weygoldt/TeeGrid/examples/R4-logger/README.md

# R4.x logger

Logger for 2 to 16 channels based on

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

Software based on the [TeeRec](https://github.com/janscience/TeeRec) library.

Designed by Jan Benda in September 2023.

## Installation

See the [installation instructions](../../doc/install.md) for the
TeeGrid library.

## Software setup

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

*WARNING* the settings of the config file overwrite the settings made
 in the sketch!

For editing the sketch, open the
[`R4-logger.ino`](R4-logger.ino) sketch in the Arduino
IDE (`File` - `Open`, `Ctrl-O`, or `File` - `Examples` - `TeeGrid` -
`R4-senosrs-logger`) and edit it appropriately.  In the top section
marked as `Default settings` you may adapt some settings according to
your needs as described in the next sections.

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

### Data acquisition

The first section is about the data acquisition:

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

### File naming and size

The second section is about the files that store the data on the SD
card.

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

#### Special strings for the file name

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

### LED pin

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

## Configuration file

Most of the settings described above can be configured via a
configuration file. Simply place a configuration file named
[`logger.cfg`](logger.cfg) into the root folder of the SD card. If
present, this file is read once on startup. The configuration file
will overwrite the settings made in the
[`R4-logger.ino`](R4-logger.ino) sketch.

The content of the configuration file should look like this:

```txt
Settings:
  Path:            recordings
  FileName:        logger1-SDATETIME.wav
  FileTime:        5min
  InitialDelay:    10s
ADC:
  SamplingRate: 48.0kHz
  NChannels:    16
  Gain:         20.0dB
``` 

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

## Real-time clock

For proper naming of files, the real-time clock needs to be set to the
right time. The easiest way to achieve this, is to compile and upload
the [`R4-logger.ino`](R4-logger.ino) sketch from the
Arduino IDE. The upload also sets the on-bard real-time clock to the
time of the computer. Use the serial monitor to check the output of
the sketch. At the beginning it reports the time. Disconnect the
Teensy from the USB and simply reconnect it. If it then reports on the
serial monitor the right time, the real time clock is properly set and
is properly powered by the coin battery.

Alternatively, you may copy a file named `settime.cfg` into the root
folder of the SD card. This file contains a single line with a date
and a time in the following format:
``` txt
YYYY-MM-DDTHH:MM:SS
```

In a shell you might generate this file via
```sh
date +%FT%T > settime.cfg
```
and then edit this file to some time in the near future.

Insert the SD card into the Teensy. Start the Teensy exactly at the
time that is written into the `settime.cfg` file by connecting it to
power. On start up the
[`R4-logger.ino`](R4-logger.ino) sketch reads in the
`settime.cfg` file, sets the real-time clock to this time, and then
deletes the file from the SD card to avoid resetting the time at the
next start up.

## Check logger function

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

```txt
=======================================================================

RTC (on-board) current time: 2024-07-23T10:24:08      # this should be the current time and not 2019-01-01T00:00:02

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

Settings:                                             # check whether these configuration settings are right
  Path:         recordings
  FileName:     logger1-SDATETIME.wav
  FileTime:     20s
  PulseFreq:    0Hz
  InitialDelay: 10s
ADC:
  SamplingRate: 48.0kHz
  NChannels:    16
  Gain:         0.0dB
Setup PCM186x 0 on TDM 0: configured for 4 channels  # make sure all 4 chips are detected and configured for 4 channels
Setup PCM186x 1 on TDM 0: configured for 4 channels
Setup PCM186x 2 on TDM 1: configured for 4 channels
Setup PCM186x 3 on TDM 1: configured for 4 channels

TDM settings:                                        # check the sampling rate
  rate:       48.0kHz
  resolution: 32bits
  channels:   16
  swap l/r:   1
  buffer:     2.73s (2097152 samples)
  DMA time:   1.3ms

Save recorded data in folder "recordings".

logger1-2024-07-23T10:24:21.wav                     # this is the first file for storing recorded data
```

## Logging

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

### Formatting the SD card

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

Formatting from a computer also helps, but this omits the erasing
part.

### LED

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

## Files

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
