weygoldt/TeeGrid/examples/SdFormatter/README.md

# SdFormatter

... formats SD cards **immediately**. To use, connect a teensy with SD-card running the script to power. The formatter will run once and print a short summary to the serial monitor, if connected. If the built-in LED turns on, the formatting process is finished. To format a new SD-card, remove the teensy from power, swap the card and repeat the process.
