weygoldt/TeeGrid/examples/R41-CAN-grid-controller/README.md

# R4.1 CAN grid controller

Control and synchronize logger units via CAN FD bus of the [Teensy_Amp R4.1](https://github.com/janscience/Teensy_Amp/tree/main/R4.1). Each [Teensy_Amp R4.1](https://github.com/janscience/Teensy_Amp/tree/main/R4.1) logger needs
to run the [R41-CAN-recorder](../R41-CAN-recorder) software.

Designed by Jan Benda in September 2023.
