weygoldt/TeeGrid/doc/pvc-tube-housing/README.md

# PVC tube housing

housing
