weygoldt/TeeGrid/examples/8channel-logger/images/bottom-1amp.jpg

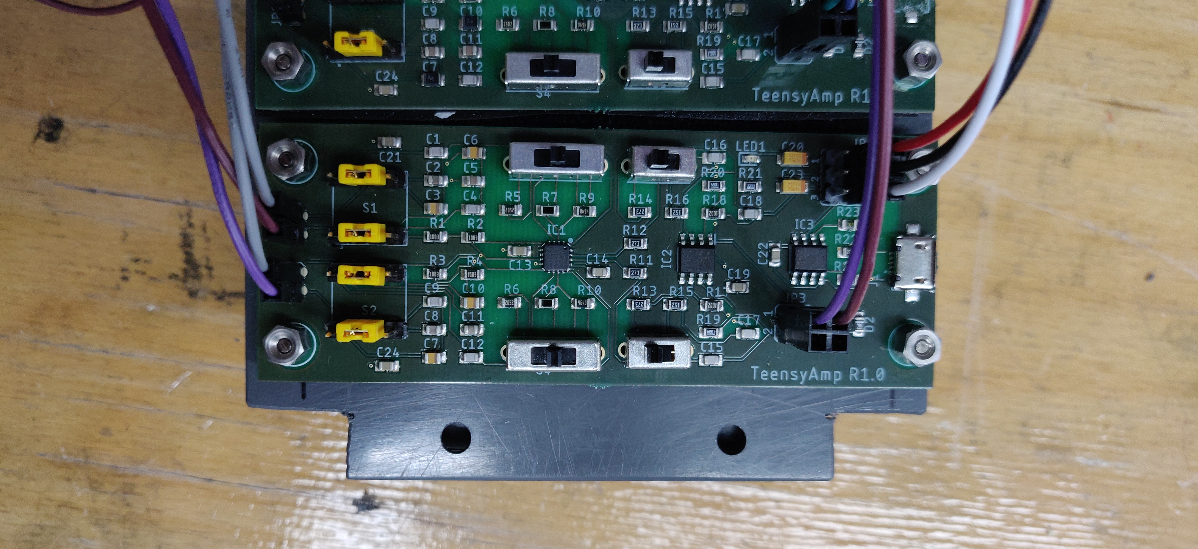
examples/8channel-logger/images/bottom-1amp.jpg
