weygoldt/TeeGrid/examples/8channel-logger/images/bottom-4amps.jpg

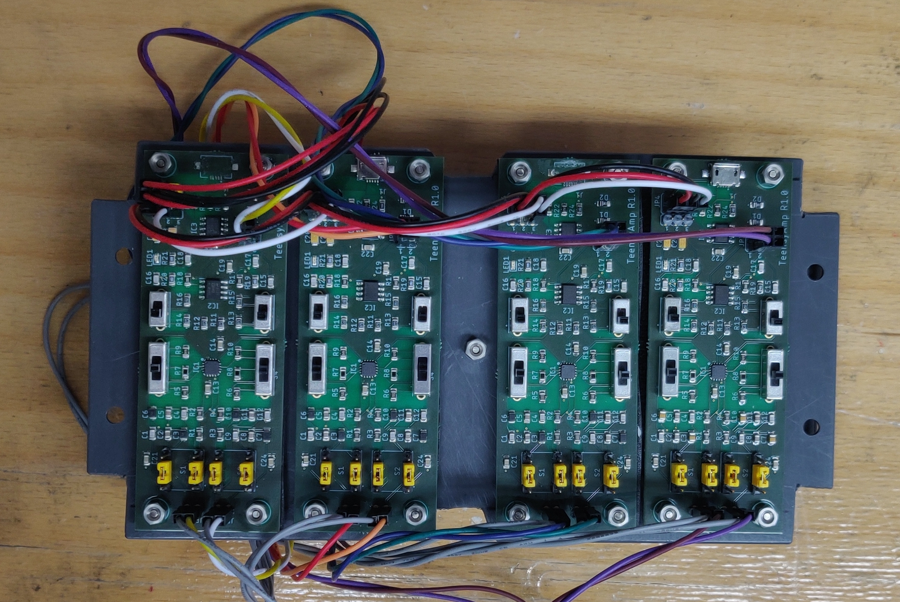
examples/8channel-logger/images/bottom-4amps.jpg
