weygoldt/TeeGrid/examples/8channel-logger/images/box-top-annotated.jpg

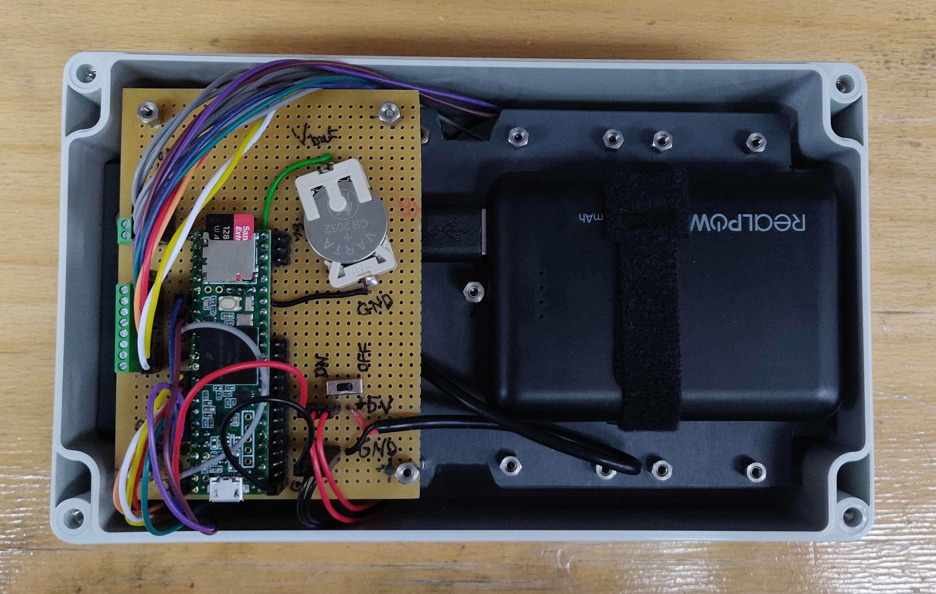
examples/8channel-logger/images/box-top-annotated.jpg
