weygoldt/TeeGrid/examples/8channel-logger/images/box.jpg

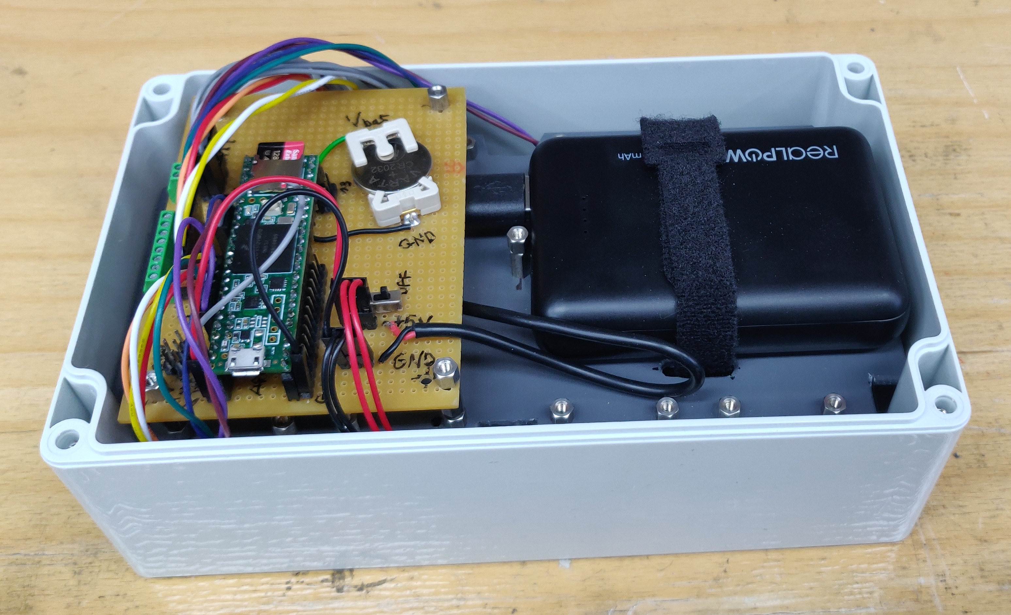
examples/8channel-logger/images/box.jpg
