weygoldt/TeeGrid/examples/8channel-logger/images/connectors.jpg

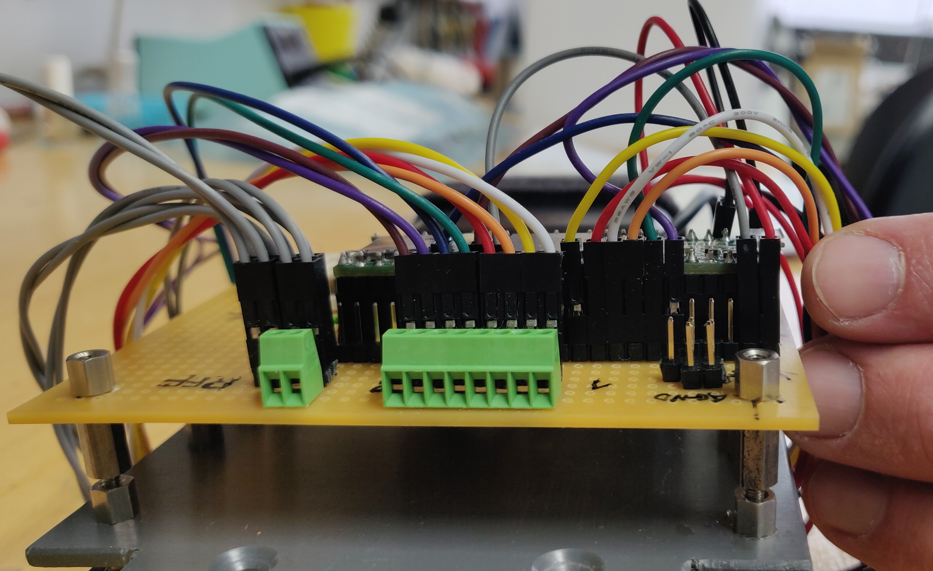
examples/8channel-logger/images/connectors.jpg
