weygoldt/TeeGrid/examples/8channel-logger/images/filter-p2-gain30-23mV-traces.png

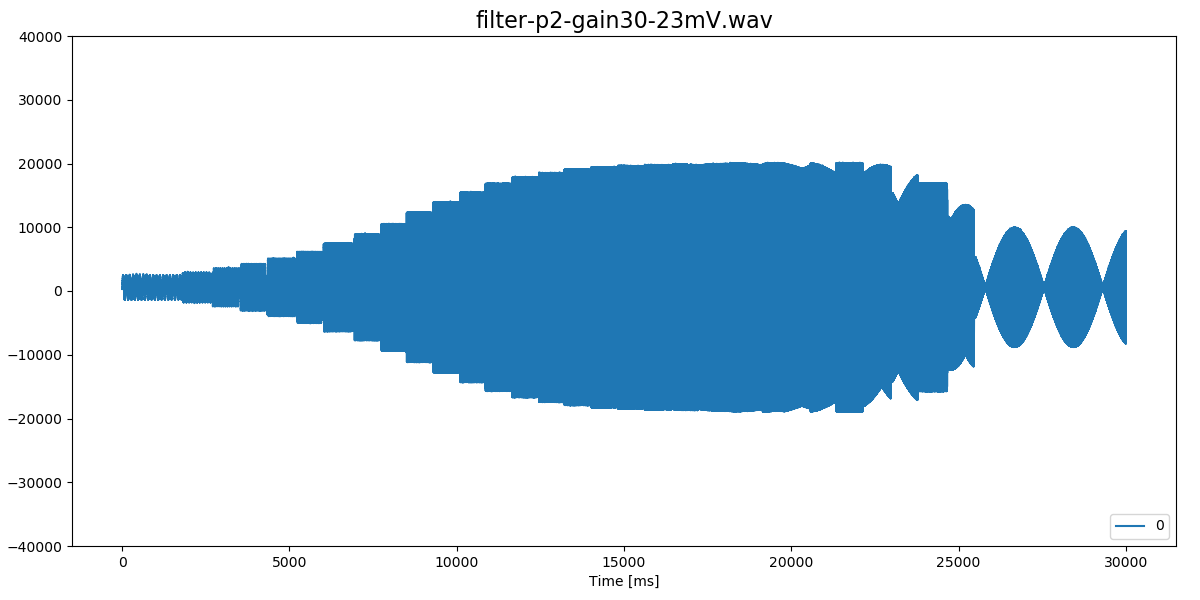
examples/8channel-logger/images/filter-p2-gain30-23mV-traces.png
