weygoldt/TeeGrid/examples/8channel-logger/images/filter-p3-gain30-23mV-traces.png

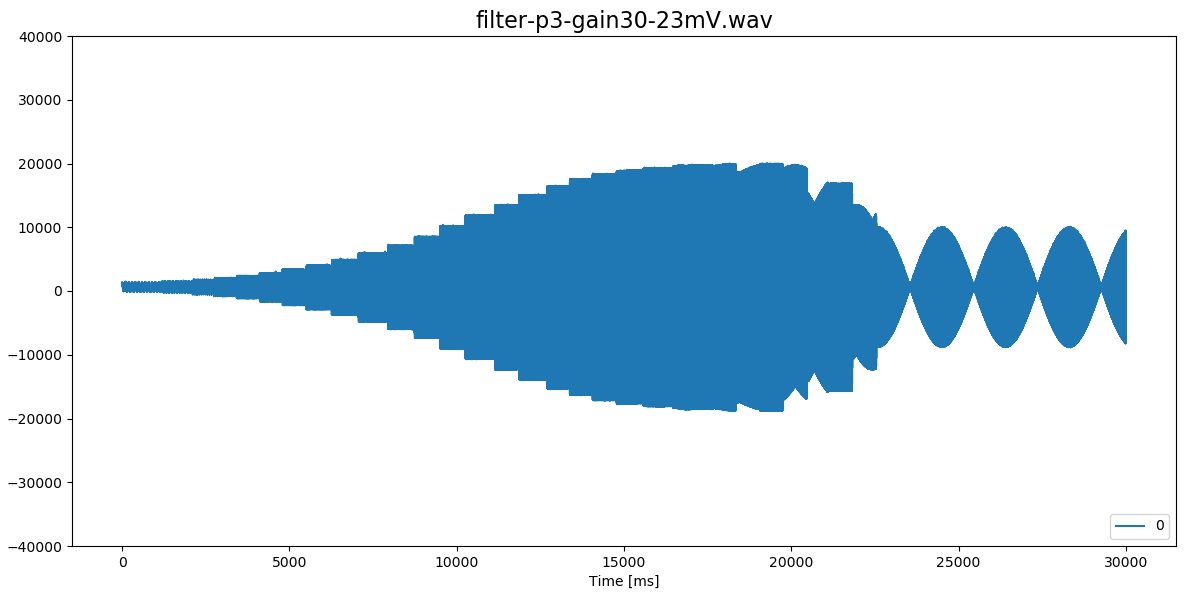
examples/8channel-logger/images/filter-p3-gain30-23mV-traces.png
