weygoldt/TeeGrid/examples/8channel-logger/images/top.jpg

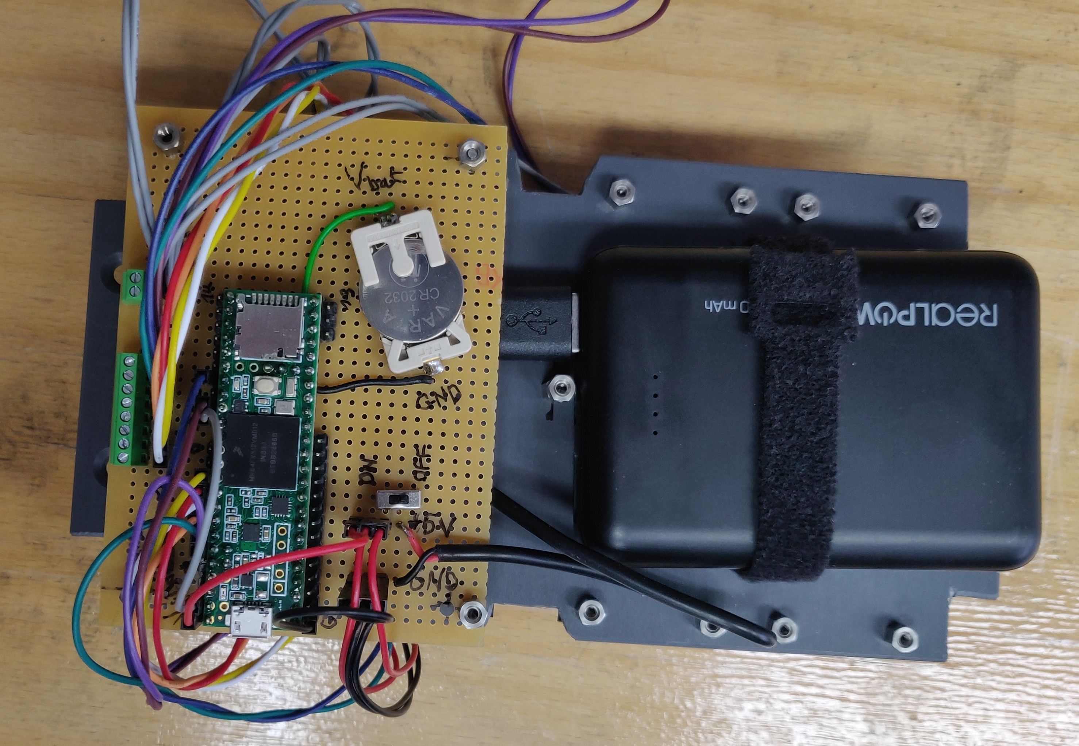
examples/8channel-logger/images/top.jpg
