weygoldt/TeeGrid/examples/R4-sensors-logger/logger-periphery-connections.jpg

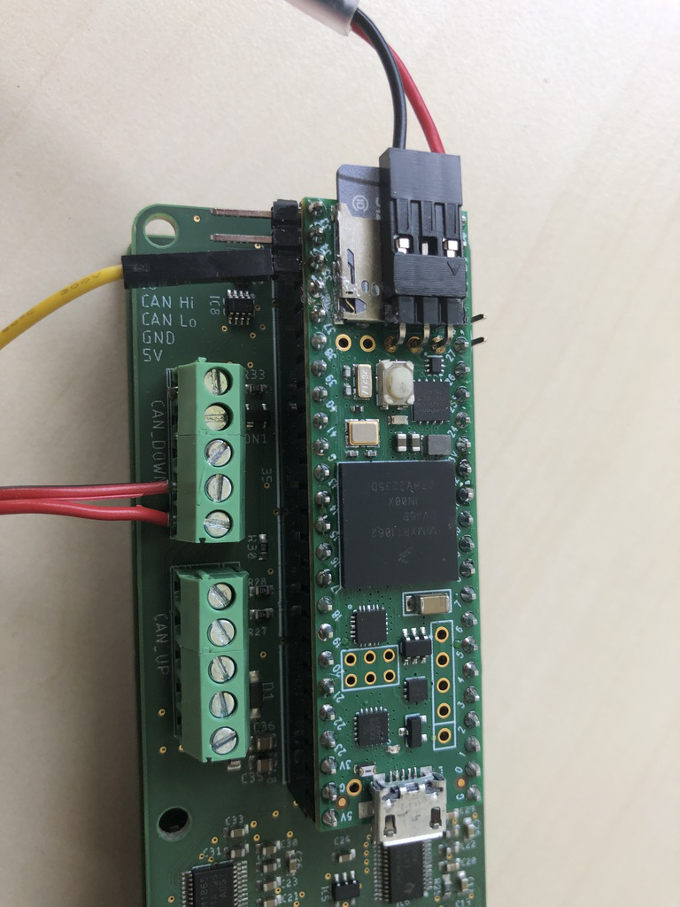
examples/R4-sensors-logger/logger-periphery-connections.jpg
