weygoldt/TeeGrid/examples/8channel-logger/images/clipping-gain5-100mV-step10mV-traces.png

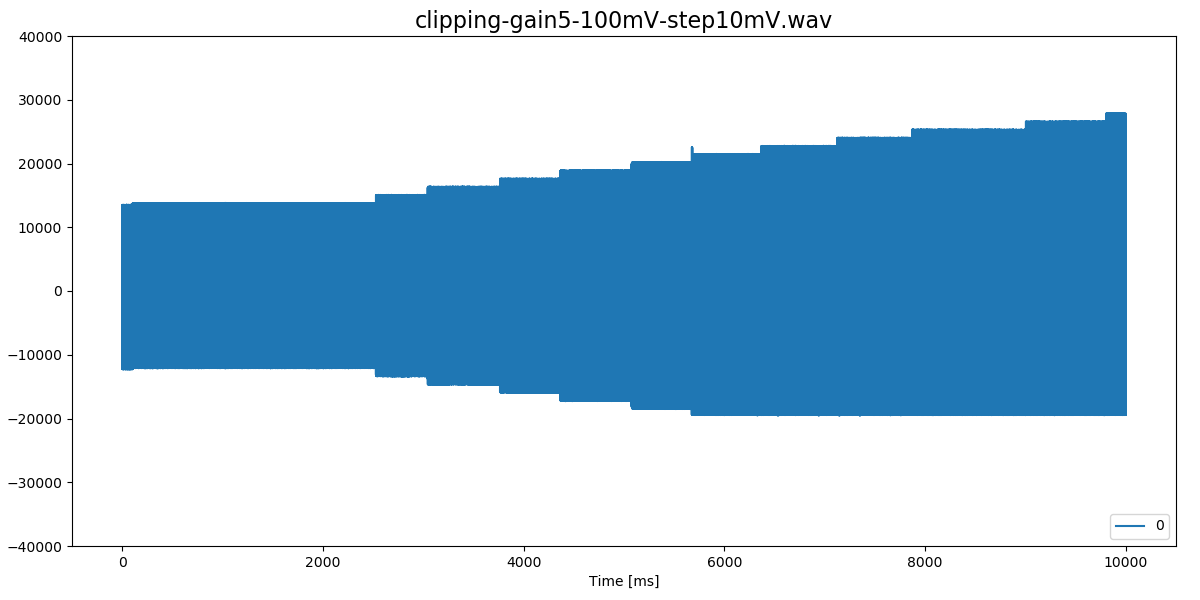
examples/8channel-logger/images/clipping-gain5-100mV-step10mV-traces.png
