weygoldt/TeeGrid/src/SetupPCM.cpp

#include <SetupPCM.h>


bool R40SetupPCM(InputTDM &tdm, ControlPCM186x &cpcm, bool offs,
		 float pregain, const InputTDMSettings &aisettings,
		 ControlPCM186x **pcm) {
  cpcm.begin();
  bool r = cpcm.setMicBias(false, true);
  if (!r) {
    Serial.println("not available");
    return false;
  }
  cpcm.setRate(tdm, aisettings.rate());
  if (tdm.nchannels() < aisettings.nchannels()) {
    if (aisettings.nchannels() - tdm.nchannels() == 2) {
      if (pregain == 1.0) {
        cpcm.setupTDM(tdm, ControlPCM186x::CH3L, ControlPCM186x::CH3R,
	              offs, ControlPCM186x::INVERTED);
        Serial.println("configured for 2 channels without preamplifier");
      }
      else {
        cpcm.setupTDM(tdm, ControlPCM186x::CH1L, ControlPCM186x::CH1R,
	              offs, ControlPCM186x::INVERTED);
        Serial.printf("configured for 2 channels with preamplifier x%.0f\n", pregain);
      }
    }
    else {
      if (pregain == 1.0) {
        cpcm.setupTDM(tdm, ControlPCM186x::CH3L, ControlPCM186x::CH3R,
                      ControlPCM186x::CH4L, ControlPCM186x::CH4R,
		      offs, ControlPCM186x::INVERTED);
        Serial.println("configured for 4 channels without preamplifier");
      }
      else {
        cpcm.setupTDM(tdm, ControlPCM186x::CH1L, ControlPCM186x::CH1R,
                      ControlPCM186x::CH2L, ControlPCM186x::CH2R,
		      offs, ControlPCM186x::INVERTED);
        Serial.printf("configured for 4 channels with preamplifier x%.0f\n", pregain);
      }
    }
    cpcm.setSmoothGainChange(false);
    cpcm.setGain(aisettings.gain());
    cpcm.setFilters(ControlPCM186x::FIR, false);
    *pcm = &cpcm;
  }
  else {
    // channels not recorded, but need to be configured to not corupt TDM bus:
    cpcm.setupTDM(ControlPCM186x::CH1L, ControlPCM186x::CH1R, offs);
    cpcm.powerdown();
    Serial.println("powered down");
  }
  return true;
}


bool R4SetupPCM(InputTDM &tdm, ControlPCM186x &cpcm, bool offs,
		uint32_t rate, int nchannels, float gain,
		ControlPCM186x **pcm) {
  cpcm.begin();
  bool r = cpcm.setMicBias(false, true);
  if (!r) {
    Serial.println("not available");
    return false;
  }
  cpcm.setRate(tdm, rate);
  if (tdm.nchannels() < nchannels) {
    if (nchannels - tdm.nchannels() == 2) {
      cpcm.setupTDM(tdm, ControlPCM186x::CH2L, ControlPCM186x::CH2R,
                    offs, ControlPCM186x::INVERTED);
      Serial.println("configured for 2 channels");
    }
    else {
      cpcm.setupTDM(tdm, ControlPCM186x::CH2L, ControlPCM186x::CH2R,
                    ControlPCM186x::CH3L, ControlPCM186x::CH3R,
                    offs, ControlPCM186x::INVERTED);
      Serial.println("configured for 4 channels");
    }
    cpcm.setSmoothGainChange(false);
    cpcm.setGain(gain);
    cpcm.setFilters(ControlPCM186x::FIR, false);
    *pcm = &cpcm;
  }
  else {
    // channels not recorded, but need to be configured to not corupt TDM bus:
    cpcm.setupTDM(ControlPCM186x::CH2L, ControlPCM186x::CH2R, offs);
    cpcm.powerdown();
    Serial.println("powered down");
  }
  return true;
}


bool R4SetupPCM(InputTDM &tdm, ControlPCM186x &cpcm, bool offs,
		const InputTDMSettings &aisettings, ControlPCM186x **pcm) {
  return R4SetupPCM(tdm, cpcm, offs, aisettings.rate(),
		    aisettings.nchannels(), aisettings.gain(), pcm);
}
