weygoldt/TeeGrid/src/CANFileStorage.h

/*
  CANFileStorage - High level handling of CAN synchronized file storage of logger data.
  Created by Jan Benda, September 18th, 2023.
*/

#ifndef CANFileStorage_h
#define CANFileStorage_h

#include <R41CAN.h>
#include <TeensyBoard.h>
#include <LoggerFileStorage.h>

#ifdef TEENSY4

class CANFileStorage : public LoggerFileStorage {
  
public:

  CANFileStorage(Input &aiinput, SDCard &sdcard0, SDCard &sdcard1,
		 R41CAN &can, bool master, const RTClock &rtclock,
		 const DeviceID &deviceid, Blink &blink);

protected:

  // Use CAN bus to synchronize opening of next file.
  virtual bool synchronize();

  R41CAN &CAN;
  bool Master;
  
};

#endif

#endif
