weygoldt/TeeGrid/(commit log)

2021-11-14 updated 8channel logger to noise test results
    [8channel-logger.ino]
2021-11-15 checked and fixed gain30 recording
    [teegrid.cfg]
2021-11-16 updated config
    [teegrid.cfg]
2021-11-16 signal wire colors
2021-11-16 added image for input connector
2021-11-16 further infos on Teensy and amplifier settings
2021-11-18 added initial delay to config file
    [teegrid.cfg]
2021-11-19 power measurements
2021-11-20 link to TeensyAmp filter section
2021-11-21 updated README to Teensy Amp docu
2021-11-27 added temperature logging
2021-11-27 global sensors parameter
2022-04-02 how to connect temperature sensor
2022-04-02 working and configurable temperature sensor
    [teegrid.cfg]
2022-04-05 sensors file names based on name for wave files to avoid overwriting
    [teegrid.cfg]
2022-04-05 fixed blinking for no file
    [8channel-logger.ino]
2022-04-06 do not initialize temperature sensor if it was configured from a file
2022-04-06 write sensor data only right after analog input data
2022-04-06 updated config file
    [teegrid.cfg]
2022-04-07 write sensor data only if SD card is not busy
2022-04-09 only a single sensors file is written
    [teegrid.cfg]
2022-04-09 sensors file is only written inbetween new files
2022-04-10 sensors file is only written shortly after file writes
    [8channel-logger.ino]
2022-04-12 10ms time interval for writing sensors
2022-04-19 restart acquisition on error - needs proofing
    [8channel-logger.ino]
2022-04-20 improved error handling of file issues
    [8channel-logger.ino]
2022-04-22 updated to renamed TemperatureDS18x20 class
2022-04-24 updated sensors settings
    [teegrid.cfg]
2022-04-30 update to Sensors
2022-05-12 new 8channel-sensors-logger sketch
    [teegrid.cfg]
2022-05-12 removed temperature from 8channel-logger
2022-05-12 [8channel-sensors-logger] late initialization of tsl
2022-12-27 renamed ContinuousADC to TeensyADC
2022-12-28 update to TeensyADCSettings
2022-12-28 fixed use of TeensyADCSettings
    [8channel-logger.ino, 8channel-sensors-logger.ino]
2023-07-27 TeensyAmp R4 based logger
2023-08-09 [R4-16channel] commonication on second I2C working
2023-08-10 [R4-16channel] still not working
    [R4-16channel-logger.ino]
2023-08-14 [R4-16channel] improving error handling
    [R4-16channel-logger.ino]
2023-08-16 [R4-16channel] updated error handling
    [R4-16channel-logger.ino]
2023-08-18 added electrodes and housings
2023-08-29 renamed TeensyADC and TeensyTDM to InputADC and InputTDM
2023-09-08 [R4-logger] fixed default parameters
    [R4-logger.ino, R40-logger.ino]
2023-09-12 [R40-logger] added config file - not working yet
    [teegrid.cfg]
2023-09-15 [CAN] working device detection
2023-09-24 [CANFileStorage] removed Serial.print
2023-09-24 [R4-sensors-logger] logger with sensor readings
2023-09-26 [R41-CAN-grid-controller] added sensors
2023-10-02 fixed InputTDMSettings constructor usage
    [CANBase.h, CANFileStorage.cpp, CANFileStorage.h, R4-logger.ino, R4-sensors-logger.ino, R41-CAN-recorder.ino]
2023-10-21 [R40-logger] updated blink and fixed pcm powerdown
    [R4-logger.ino, R40-logger.ino]
2023-10-21 [R4-logger] updated blink and fixed pcm powerdown
    [R4-logger.ino]
2023-10-21 updated blink for both LEDs
2023-10-21 [R4-sensors-logger] added some notes
2023-11-21 [electrodes] added color code
2024-08-08 [examples] moved sketches to examples folder
    [teegrid.cfg]
2024-08-08 [R4-sensors-logger] detailed README
2024-08-08 [R4-sensors-logger] improved README
    [logger.cfg]
2024-08-08 [R4-sensors-logger] fixed README
2024-08-08 [R4-sensors-logger] added connection images for peripherals
2024-08-08 [R4-sensors-logger] added output from serial monitor
2024-08-09 [R4-sensors-logger] added the right serial monitor output
2024-08-12 [R4-sensors-logger] improved serial output
2024-08-16 [examples] print out SOFTWARE on startup
2024-08-16 [R4-sensors-logger] added interactive configuration
2024-08-17 [R4-sensors-logger] added erase and format to menu
2024-08-17 [R4-sensors-logger] added SD card check
2024-09-23 [R4-sensors-logger] fix conflict leftover, updated menu
    [R4-sensors-logger.ino]
2024-09-23 [R4-sensors-logger] small fixes
2024-09-24 [TeeGridBanner] also print out TeeRec version
2024-09-25 [FileStorage] fixed error handling
    [FileStorage.cpp]
2024-09-26 [FileStorage] reopen SD card on failure
    [FileStorage.cpp, FileStorage.h]
2024-09-29 [LoggerFileStorage] fixed error messages
    [LoggerFileStorage.cpp]
